bobobo1618/iot-environment-sensor/board.brd

## EAGLE design board.brd (2020-02-19)

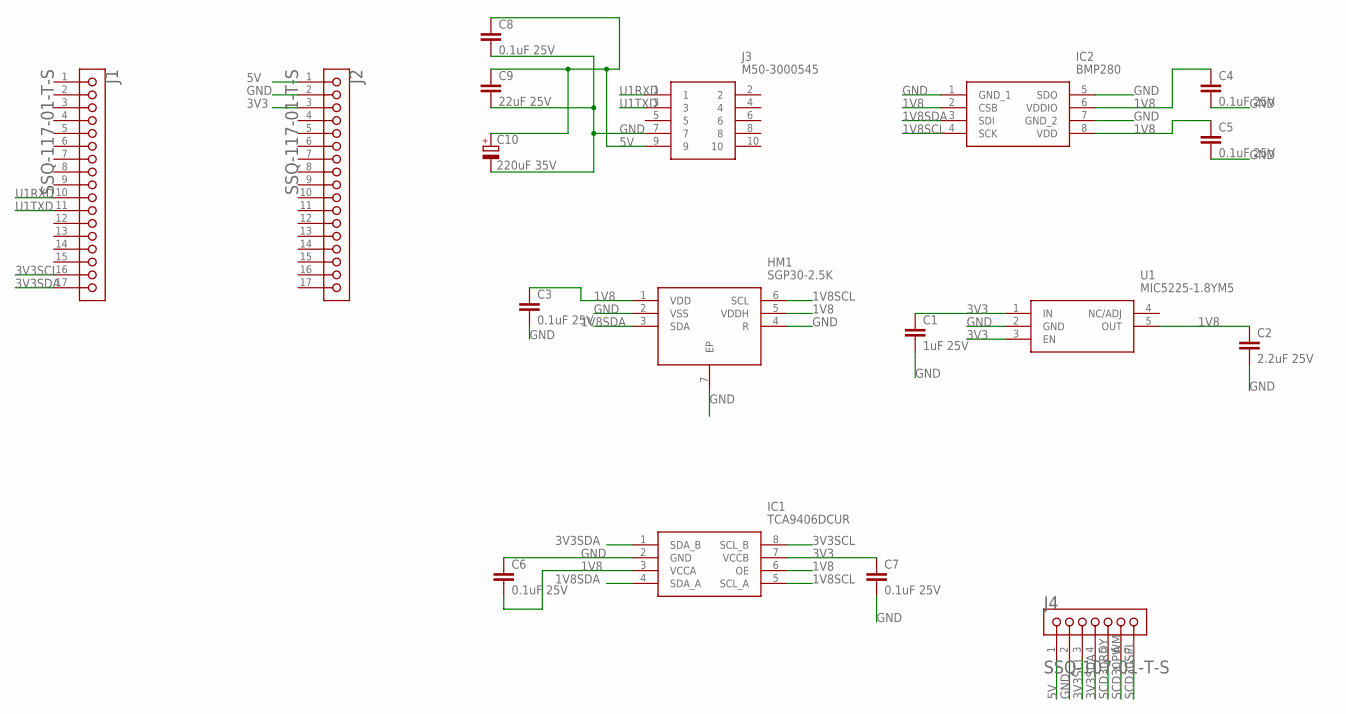
[picture p3: schematic board.sch]

Parts:
C1: 1uF 25V; C0402
C2: 2.2uF 25V; C0402
C3, C4, C5, C6, C7, C8: 0.1uF 25V; C0402
C9: 22uF 25V; C0805
C10: 220uF 35V; E5-10,5
HM1: SGP30-2.5K; SON80P245X245X90-7N
IC1: TCA9406DCUR; SOP50P310X90-8N
IC2: BMP280; 8-PIN-METAL-LID-LGA_1
J1, J2: SAMTEC_SSQ-117-01-T-SSAMTEC_SSQ-117-01-T-S_0_0; SAMTEC_SSQ-117-01-T-S_0
J3: M50-3000545; SHDR10W40P127X127_2X5_675X310X
J4: SAMTEC_SSQ-107-01-T-SSAMTEC_SSQ-107-01-T-S_0_0; SAMTEC_SSQ-107-01-T-S_0
U1: MIC5225-1.8YM5; SOT95P280X145-5N

Connections:
1V8: C2.1, C3.1, C4.1, C5.1, C6.2, HM1.1 (VDD), HM1.5 (VDDH), IC1.3 (VCCA), IC1.6 (OE), IC2.2 (CSB), IC2.6 (VDDIO), IC2.8 (VDD), U1.5 (OUT)
1V8SCL: HM1.6 (SCL), IC1.5 (SCL_A), IC2.4 (SCK)
1V8SDA: HM1.3 (SDA), IC1.4 (SDA_A), IC2.3 (SDI)
3V3: C1.1, C7.1, IC1.7 (VCCB), J2.3, U1.1 (IN), U1.3 (EN)
3V3SCL: IC1.8 (SCL_B), J1.16, J4.3
3V3SDA: IC1.1 (SDA_B), J1.17, J4.4
5V: C8.1, C9.1, C10.+, J2.1, J3.9, J4.1
GND: C1.2, C2.2, C3.2, C4.2, C5.2, C6.1, C7.2, C8.2, C9.2, C10.-, HM1.2 (VSS), HM1.4 (R), HM1.7 (EP), IC1.2 (GND), IC2.1 (GND_1), IC2.5 (SDO), IC2.7 (GND_2), J2.2, J3.7, J4.2, U1.2 (GND)
SCD30PWM: J4.6
SCD30RDY: J4.5
SCD30SEL: J4.7
U1RXD: J1.10, J3.1
U1TXD: J1.11, J3.3

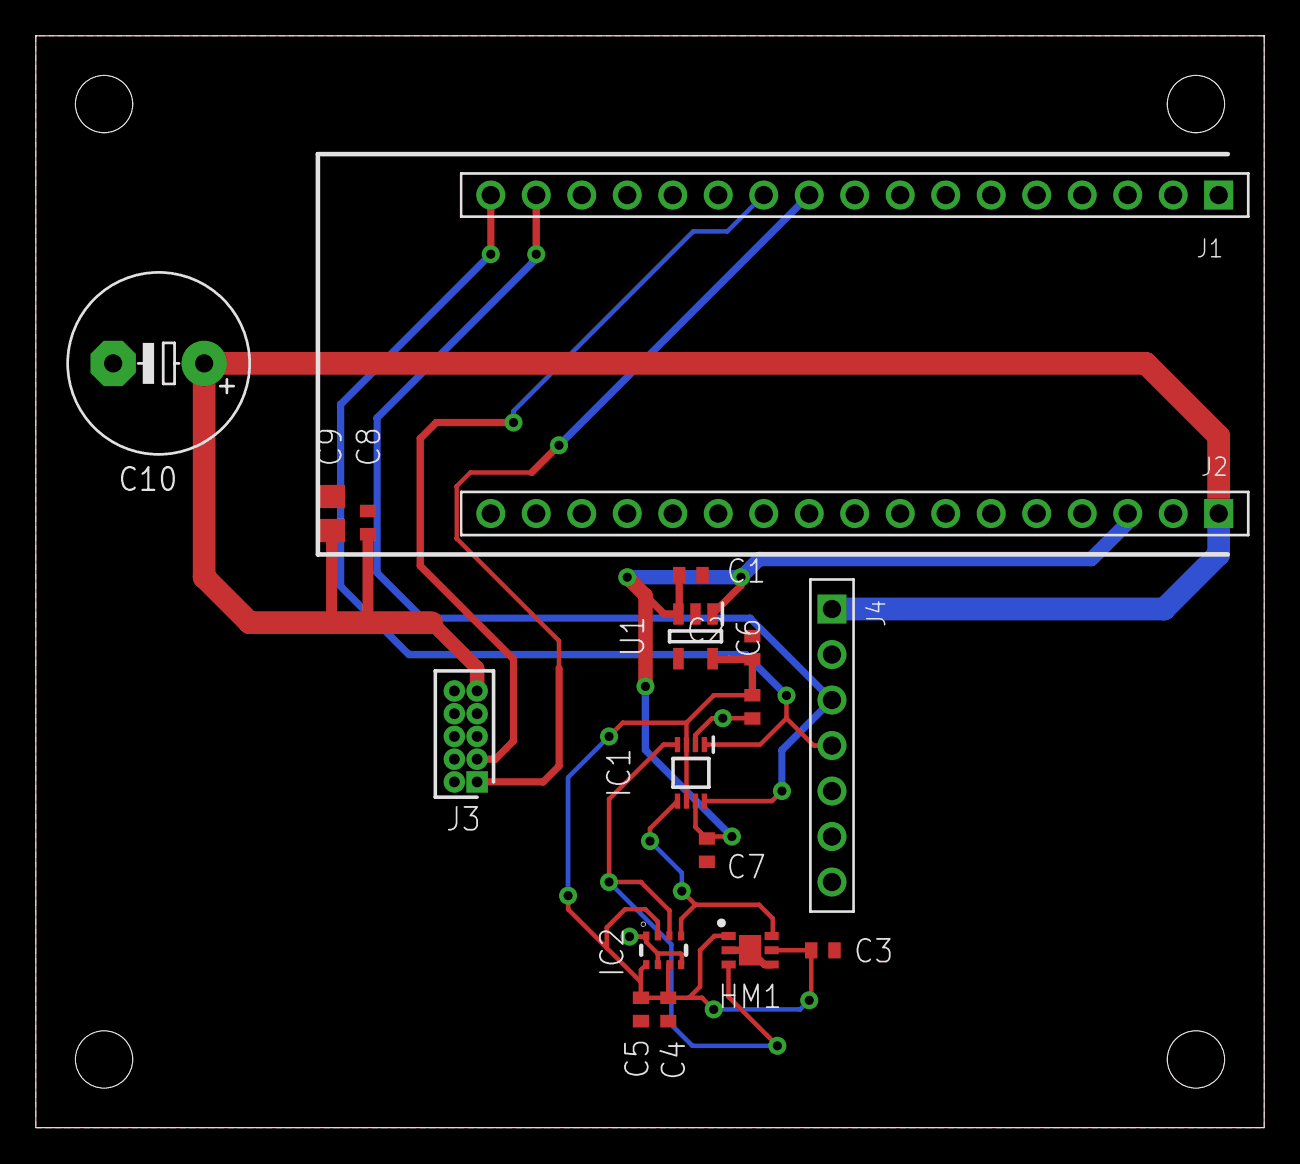
[picture p4: board board.brd from above]

Board: 2 copper layers, 68.6 x 61.0 mm, 18 parts (0 on the bottom side), 10 nets.
