bobobo1618/iot-environment-sensor/(commit log)

2020-02-19 Add board
    [board.sch]
2020-02-19 Add Kicad conversion
    [board.kicad_pcb, board.sch]
